MohmdNaeem/de2-115-shape-detection/(notices)

Notices in the files:
README.md:
License: MIT
